jaredmcqueen/hot-wheels-radar-gun/photos/soldered wire.JPG

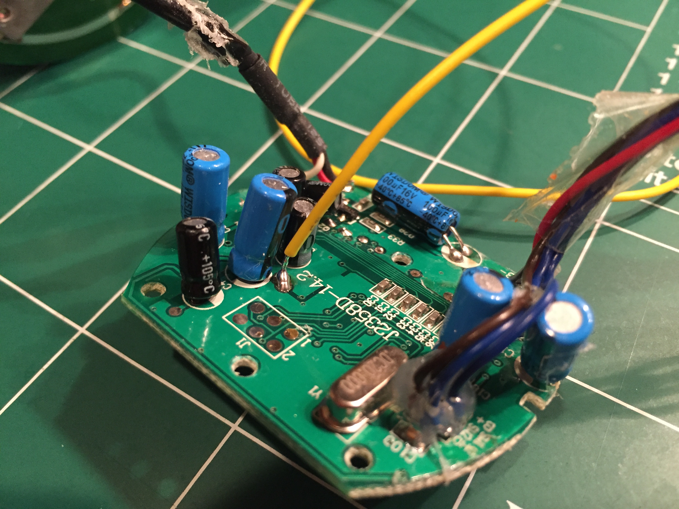
photos/soldered wire.JPG
