jaredmcqueen/hot-wheels-radar-gun/photos/hot wheels gun parts.JPG

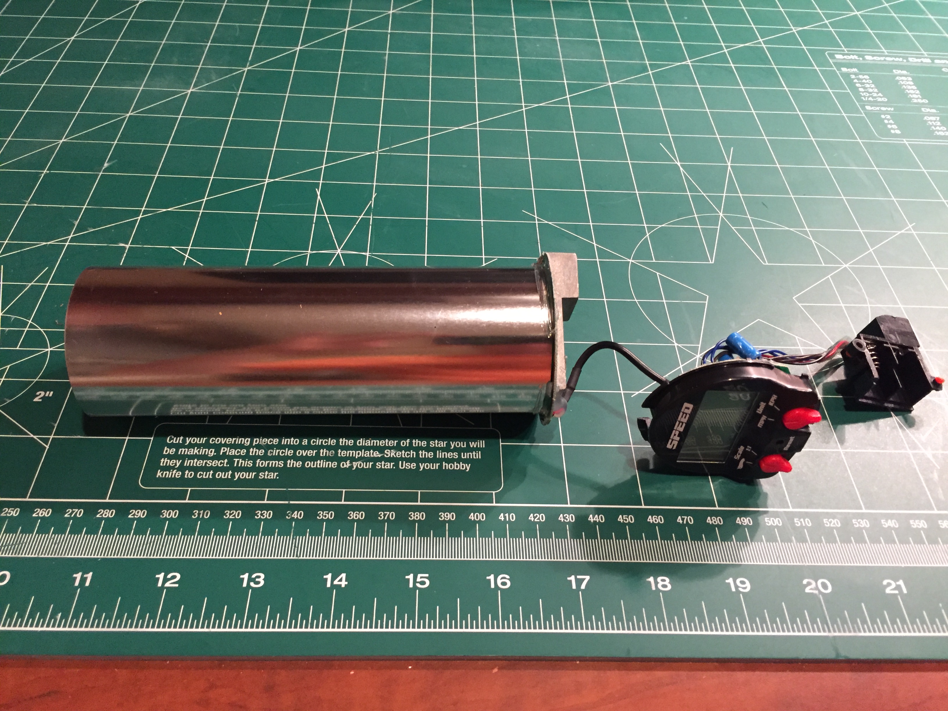
photos/hot wheels gun parts.JPG
