jaredmcqueen/hot-wheels-radar-gun/README.md

# hot-wheels-radar-gun

Catch speeders with an arduino, raspberry pi, and a Hot Wheels Radar Gun.

The Hot Wheels Radar Gun uses a cheap HB100.

Check out this repo for more info:
* https://github.com/3zuli/HB100_test

This HB100 with backpack will give you the best sensitivity and range:
* https://www.tindie.com/products/limpkin/hb100-doppler-speed-sensor-arduino-compatible/

Overall, I feel the HB100 is not ideal for medium range vehicle detection.  You'll need something like a sensor from rfBeam:
* http://www.rfbeam.ch/products/k-mc1-transceiver/
* http://www.rfbeam.ch/products/k-mc3-transceiver/
